cohenor1112/Autonomous-vehicle-W-arduino/פרויקט תחרותי-ספר פרויקט -אור יוני ועידו.pdf

המכללה האק דמית להנדסה אורט בראודה המחלקה להנדסת חשמל ואלקטרוניקה

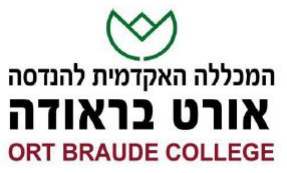
[picture p1: figure]

1

# המחלקה להנדסת חשמל ואלקטרוניקה

# עגלה אוטונומית תחרותית

מוגש ע"י: עידו עזרא ת.ז: 209453935

אור כהן ת.ז: 318300373

יונתן מסטר ת.ז: 311557649

בהנחיית: ד"ר פנחס זורע

2

תקציר:

בפרוייקט זה נעסוק בתכנון ויישום של עגלה אוטונומית תחרותית ,אשר תדע לקלוט אותות אינפרא-אדומים שמשודרים מקצהו השני של החדר. העגלה תבצע מספר בדיקות עד שתמצא את כיוון האות המשודר, ותגיע למשדר תוך כדי הימנעות ממכשולים פיזיים שלבסוף תעצור לידו.

מטרת הפרויקט היא להתחרות בעגלות אוטונומיות אחרות, תוך כדי התגברות על אתגרים שונים המגיעים ממספר גורמים והגעה ליעד בזמן הקצר ביותר בדיוק הרב ביותר.

את האותות הIR יישלח מכלול השידור אשר ימוקם בקצה החדר .אותות הIR מאופננים בתדר 38 KHZ.

את הקליטה והפיענוח מבצע מכלול הקליטה של המערכת. מכלול זה מורכב מ 3- מקלטי IR .מכלול הקליטה מבצע דגימה של המקלטים לאורך כל זמן העבודה של המערכת , ומשדר את המידע הנקלט והרלוונטי למכלול הבקרה ועיבוד נתונים-אותו מכלול שיקבע איך העגלה תתקדם במסלול.

בנוסף לשני המכלולים הנ"ל קיימים עוד שני מכלולים חשובים לא פחות. מכלול ההנעה- מורכב מארבעה מנועי DC אשר מקבלים מתח ממקור חיצוני ,ותוך כדי שימוש בממסרי זרם והגברת הזרם הרצוי, מספקים את הכח הנדרש להזזת המנועים לכיוון הרצוי,על פי הנקבע במכלול העיבוד והקליטה.

מכלול עצירה וזיהוי מכשולים- על מנת למנוע התנגשויות בעצמים והתחמקות ממכשולים בחדר תוכנן מכלול זה. מכלול מורכב מ4 חיישנים אולטרה-סונים המבצעים מדידות באופן רציף לאורך התקדמות העגלה ,ונותנים חיווי למכלול הבקרה האם העגלה נמצאת במרחק אפשרי להתקדמות, ואם ישנו מכלול בדרך, תתריע בהתאם וכך העגלה תפעל לעקיפת המכשול .

על כל המכלולים הנ"ל מפקח מכלול בקרה ועיבוד נתונים. תפקידו של המכלול הוא לקבל את הנתונים מכל החיישנים השונים תוך כדי עיבוד יעיל וביצוע פעולות בכדי לעמוד בדרישות הפרויקט ולהשלים את מטרת הפרויקט.

תכנון הפרויקט כולל תכנון של סט בדיקות שונות עבור המכלולים השונים-שידור,קליטה,בלימה והנעה. הבדיקות השונות כללו סט בדיקות פיזי ותוכנתי במעבדה-לכל מכלול בנפרד. לאחר תכנון וביצוע כל מכלול בנפרד,ותוך כדי שיפור וייעול תמידי של כל אחד מהמכלולים בוצעה איטגרציה בין שאר המכלולים.

3

תוכן עניינים:

.1 מבוא | 5 |
.2 תיאור המערכת | 5...
.2.1 פעולת המערכת/דרישות המערכת5 |
.2.2 מפרט פונקציונלי6 |
.2.3 מפרט טכני6-7 |
2.4 תרשים מלבנים 7 |
.2.5 פירוט מכלולי המערכת8 |
.2.5.1 תכן מכלול עצירה וזיהוי מכשולים8 |
.2.5.2 תכן מכלול הנעה9-10 |
.2.5.3 תכן מכלול בקרה ועיבוד נתונים11-12 |
.2.5.4 תכן מכלול הקליטה13-14 |
.2.5.5 תכן מכלול השידור15-17 |
.3 מטלות הנדסיות18 |
3.1 תיאור המטלות18 |
3.2 אתגרים הנדסיים18 |
.4 סיכום 19 |
4.1 עמידה בדרישות 19 |
4.2 סימוכין 20 |

4

רשימת טבלאות:

טבלה :1 פירוט מכלולי המערכת 6-7 |
טבלה :2 טבלת אמת של מנועי המערכת10 |
טבלה :3 עמידה בדרישות הפרויקט19 |

רשימת איורים:

איור :1 תרשים מלבנים 7 |
איור :2 אופן פעולת חיישן האולטרא סוני 8 |
10 | shield for Arduino Mega :3 איור
איור :4 תרשים זרימת המערכת 11 |
איור :5 תרשים זרימת המערכת במצב זיהוי IR12 |
איור :6 מכלול קליטה- טווח רחוק 13 |
איור :7 מכלול קליטה- טווח קרוב 13 |
איור :8 מכלול שידור אות IR-לטווח רחוק15 |
איור :9 מכלול שידור אות IR - טווח קרוב 16 |
איור :10 פיזור זוויתי של קרן האינפרא-אדום17 |

5

.1מבוא:

עגלה אוטונומית תחרותית היא עגלה אשר תזהה מקור אור אינפרא-אדום, תתביית עליו ותגיע אליו במהירות רבה.
מטרת הפרויקט היא תחרות בין קבוצות שונות .עגלה אוטונומית תחרותית מאפשרת משחק תחרותי מסוג כזה. העגלות הנוספות יהיו מאותו "בסיס" אך יפעלו באופן שונה. מטרת המשחק הינה להגיע מנקודת ההתחלה ועד לנקודת הסיום. המנצח ייקבע על פי 3 פרמטרים:
- מהירות ההגעה לעבר היעד.
- דיוק ההגעה לעבר היעד.
- יכולת התגברות על מכשולים

העגלה תדע להגיע לעבר היעד שלה על ידי זיהוי של מקור אינפרא-אדום המשדר באופן קבוע מצידו השני של החדר ולהגיע אליו. על העגלה ישלוט בקר אשר יידע להפעיל את המנועים עד להגעה ליעד, תוך הימנעות ממכשולים קיימים ע"י חיישנים אולטרה סונים.

.2 תיאור המערכת:

### 2.1 פעולת המערכת/דרישת המערכת:

המערכת תדע לזהות מקור אור אינפרא-אדום בודד אשר נמצא בחדר. המערכת תדע להתביית על המקור לכוון את העגלה ולהגיע למקור האור.

המערכת מבוססת על בקר מסוג Mega Arduino , מקלטי אינפרא-אדום ומשדרי אינפרא-אדום אשר ישמשו למציאת מקור האור וגם לעצירת העגלה לאחר ההגעה אל המטרה. הבקר יקבל מידע דיגיטלי ישירות מהחיישני אינפרא-אדום וידע לעבד אותו על מנת לכוון את העגלה למטרה שלה.

בנוסף המערכת כוללת ארבעה מנועי DC אשר אחראיים על צידוד ימינה או שמאלה וקידום העגלה לעבר המטרה ופלטפורמה עם גלגלים אשר תוכל לשנע את כל הרכיבים.

המערכת תדע לספק קרן אור אינפרא-אדומה מקצה אחד של החדר לקצה השני על ידי תיאום תדרים והגברת האות.

בנוסף, המערכת כוללת חיישנים אולטרא-סוניים שתפקידים מניעת התנגשות העגלה בעצמים ומכשולים בדרכה ליעד.

- המערכת תהיה אוטונומית לחלוטין.
- המערכת תהיה זמינה לפעולה בזמן של עד 15 שניות.
- המערכת תזהה מטרות IR לטווח של עד 5 מטרים.
- המערכת תסחוב משקל של עד 0.3 ק"ג לעבר המטרה.
- המערכת תדע לעבוד בחדרים מישוריים ללא מהמורות מדרגות או הפרשי גבהים בקרקע.

6

### 2.2 מפרט פונקציונלי:

- יכולת סריקת חדר ומציאת מקור אור אינפרא-אדום.
- יכולת התבייתות על מקור האור ונסיעה מדוייקת אליו.
- יכולת תיקון עצמי של כיוון הנסיעה.
- יכולת נשיאת משקל לעבר המטרה.
- יכולת זיהוי מכשולים והימנעות מהם

### 2.3 מפרט טכני:

| | מכלולי המערכת תפקיד פרמטרים
משדרי 333 IR עם דוחף זרם 38 KHz : עבודה תדר-Arduino Uno | | .1 מכלול שידור ייצור קרן אור אינפרא-אדומה.
IR TSOP 34838f מקלטי 38 KHz: עבודה תדר-Arduino Nano | יצירת תחום קליטת אור של 90⁰ בקידמת העגלה וקליטת אור אינפרא-אדום המגיע ממכלול השידור. תרגום רמת האור הנקלטת לפלט דיגיטלי המוזן לתוך מכלול הבקרה והעיבוד. | מכלול קליטה 2.
Arduino mega 2560 | עיבוד המידע המגיע מהחיישנים והפעלת מכלול ההנעה בהתאם לאלגוריתם. | מכלול בקרה ועיבוד 2. נתונים
TT130-Gear DC motor מנוע-X4 )עם דוחף זרם לכל מנוע( | הנעת העגלה לעבר המטרה במהירות ובדיוק המקסימלי. | .4 מכלול הנעה
חיישן מרחק אולטראסוני 4X 2 מרחק מקסימלי: m4 -מרחק מינימלי:cm - | הפסקת הפעולה של מכלול ההנעה כאשר העגלה הגיע למטרה שלה. | .5 מכלול עצירה וזיהוי מכשולים

טבלה 1 : פירוט מכלולי המערכת

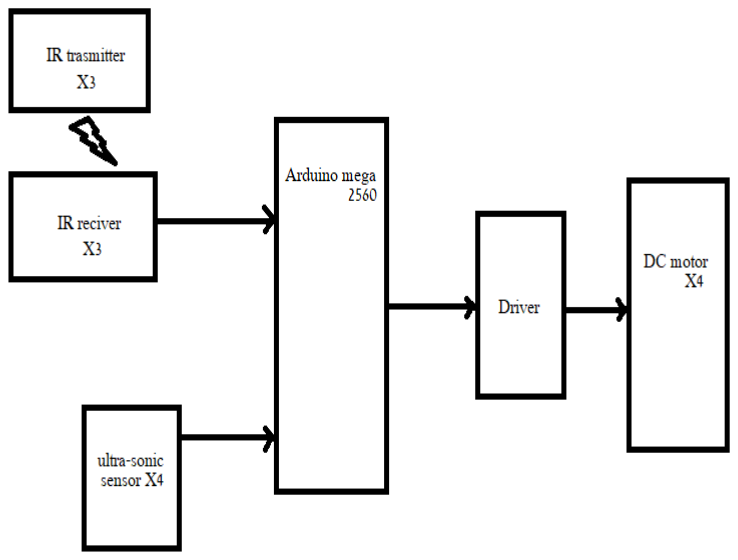
[picture p2: figure]

7

### 2.4 תרשים מלבנים

איור :1תרשים מלבנים

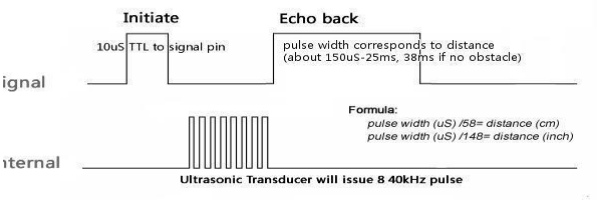
[picture p3: figure]

8

### 2.5 פירוט מכלולי המערכת

### 2.5.1 תכן מכלול עצירה וזיהוי מכשולים

מטרת מכלול זה היא לספק למערכת יכולת לזהות עצמים במרחקים שונים, וע"י עיבוד הנתונים מאפשר התחמקות ממכשולים שונים שהעגלה תפגוש ,בדרך אל המשדר IR . ועצירה ברגע הגעתו אל המשדר.

רכיבי המכלול:

]1] Ultrasonic Ranging Module HC – SR סוני- | אולטרא | חיישן | •

אופן פעולת החיישן האולטראסוני:

- החיישן בנוי ממשדר ומקלט פולסים חשמליים.
- המשדר , משדר אות אולטרא-סאונד בתדר של 40 ]KHz ]לחלל החדר.
- האות פוגע בעצם כלשהו שנמצא מול החיישן ומחזיר את האות למקלט.
- החיישן ייכנס לפעולה תחת התנאים הבאים:

תחילה החיישן יקבל פולס ברוחב של [µ [,10 זה אות ה – Trigger.

לאחר מכן החיישן ישדר 8 פולסים אולטראסוניים רצופים ואז ייכנס למצב קליטה, Echo.

איור :2 אופן פעולת החיישן האולטרא סוני

בזמן ה – Echo החיישן ימתין לחזרת האות ששידר ויתזמן את חזרתו.

מכלול זה עובד באופן רציף ומודד את המרחק לעצם הקרוב ביותר שיכול להפריע לפעולת העגלה. המרחק המינימלי הנדרש לתפעול המעגל ולהימנע מפגיעה בעצם שכזה נקבע על ידי חישוב מימדי העגלה.

9

### 2.5.2 תכן מכלול הנעה:

- מטרתו של מכלול זה היה לנייד את העגלה מנקודה אחת לנקודה מסויימת , במהירויות שונות .
- למכלול זה נבחרו 4 מנועי DC מסוג TT ,130 וshield אשר הורכב על גבי בקר ה arduino mega. כאשר ה-shield מתנהג כדוחף זרם למנועים וכך מספק זרם מספיק להפעלת המנועים בטווח מהירויות על פי דרישה .
- ארבעת המנועים מחוברים ע"י קווי Vcc ו GND למתחי האספקה והאדמה של ה-shield.
- מכיוון שמנוע הוא צרכן זרם גדול ובפרויקט זה ישנם 4 מנועים שצריכים לעבוד לפרקי זמן ארוכים אין ביכולתו של בקר ה-mega arduino לספק את הזרם הנדרש לצורך הפעלתם,לשם כך הורכב ה-shield.
- ה-shield מחובר ע"י פינים לבקר ה-mega arduino ,וע"י כך אנו מבקרים את הפעלת המנועים ע"פ הלוגיקה שנתונה בטבלה הבאה.

רכיבי המכלול:

TT130-Gear DC motor | מנועי | 4•

Compatible shield for Arduino Mega •

Direction Of Rotation | m1,m3 | m2,m4
Backward | LOW | LOW
Right | LOW | HIGH
Left | HIGH | LOW
Forward | HIGH | HIGH

טבלה 2 : טבלת אמת של מנועי המערכת]6[

סיווג המנועים:

m2- front left motor* | m1- front right motor.*
. m4- rear left motor.* | m3- rear right motor*

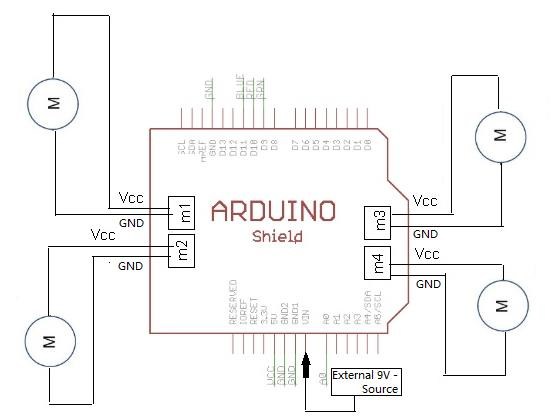
[picture p4: figure]

10

תנועת העגלה תלויה במצבים שונים בהתאם לקריאות המגיעות מהחיישנים במערכת. כל תנועה מחולקת לפונקציה ספציפית שיודעת לתת את המתחים הרלוונטיים עבור כל מנוע בנפרד ולבצע את עבודתה.

shield for Arduino Mega :3 איור

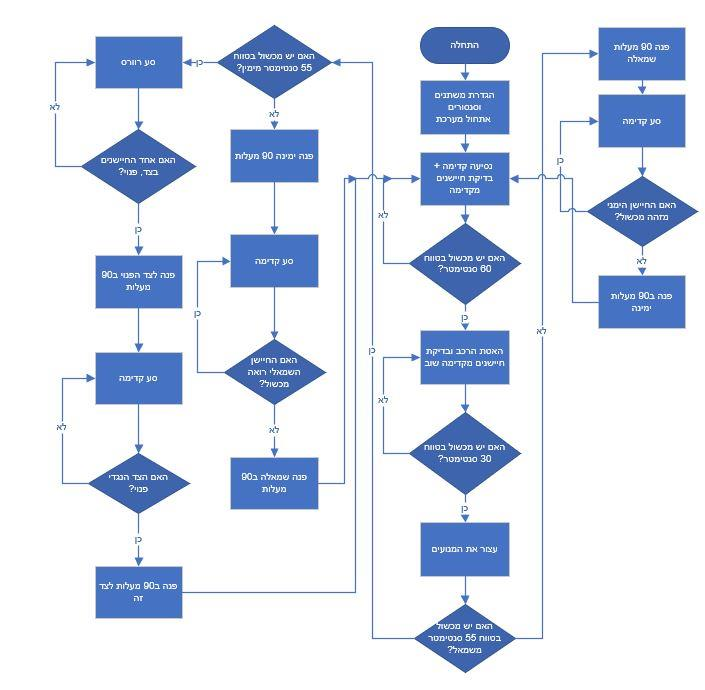
[picture p5: figure]

11

### 2.5.3 תכן מכלול בקרה ועיבוד נתונים:

מטרת המכלול: איסוף כלל המידע והנתונים השונים המגיעים מכל המכלולים במערכת ולקבל החלטות לגבי שלבי הפעולה הבאים של העגלה כאשר לבסוף היא מבצעת את מטרתה.

איור :4 תרשים זרימת המערכת

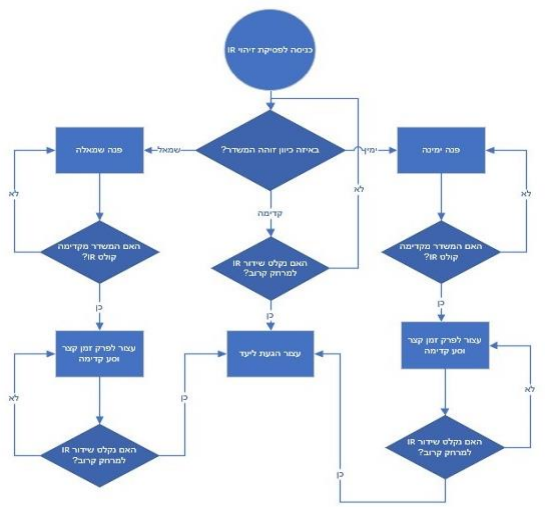
[picture p6: figure]

12

בסוף לכך קיים תרשים זרימה ממשיך למצב שבו בוצעה פסיקה כלומר זוהה אות IR:

איור :5 תרשים זרימת המערכת במצב זיהוי IR

החומרה הנמצאת בשימוש במכלול - Mega Arduino 2560[ 3 ]:

- בפרוייקט זה לא קיימת דרישה ליכולת עיבוד נתונים ברמה גבוהה במיוחד, ולכן השימוש במיקרו בקר מהסוג הזה עונה על דרישות הפרויקט.
- גודל ומשקל הבקר קטנים יחסית ומתאימים לאפליקציה שלנו.

קליטת אות אינפרא-אדום:

בקר ארדואינו ננו מנהל את כל מערך הקליטה )3 מקלטים( , תחנת השידור משדרת בתדר מסויים המקלטים קולטים ומעברים את המידע לננו , הוא מחשב את התדר שנקלט ואם זה התדר שהגדרנו מראש הננו יבצע פסיקה למגה" ויגיד לו" איזה מקלט קלט , כלומר איזה כיוון.

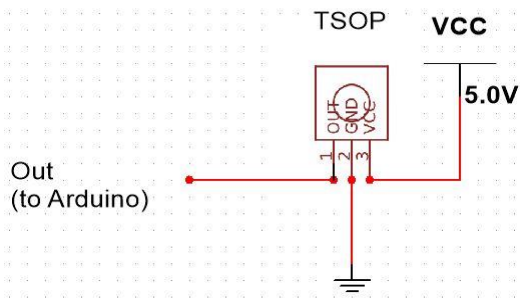
[picture p7: figure]
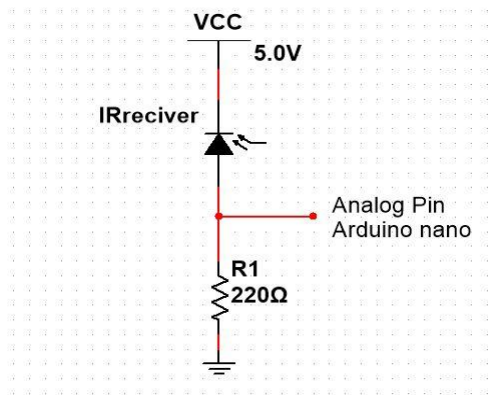
[picture p8: figure]

13

### 2.5.4 תכן מכלול הקליטה:

החומרה שבשימוש במכלול:

34838. IR – TSOP | מקלטי | •
- בקר מסוג Nano Arduino.
- בקר מסוג Mega Arduino.

שרטוט מערך הקליטה:

איור :6 מכלול קליטה-טווח רחוק

בעצם המקלט קולט ומעביר דרך רגל 1 את המידע לארדואינו ננו שנותן פסיקה לארדואינו מגה.

מלבד הקליטה הרגילה, למערכת ישנה אופציה לזיהוי תחנת השידור ע"י מקלטים IR לטווח קרוב:

איור :7 מכלול קליטה-טווח קרוב

14

הבקר שאחרי על הקליטה בודק לאחר שזוהתה תחנה את המקלטים לטווח קרוב, אם ערכם גדול עולה על ערך מסוים המקלטים מודיעים לרכב שזוהתה תחנה.

יתרונות המכלול:

- מאפשר קליטה של מידע מאופנן בתדר עבודה של 38 KHz
- מקלט זול ואמין אשר עובד בטווח התדרים הרצוי [KHz [.38-40
- טווח קליטת המשדר בתנאי מעבדה-עד 5 מטר
- טווח קליטת קרני אינפרא אדום – 90 מעלות.
- זיהוי תחנת שידור בפריסה של 180 מעלות.
- עגינה בתחנת שידור
- על מנת להימנע מהפרעות בסביבה נבנה קייס למקלט להפחתת רעשים.

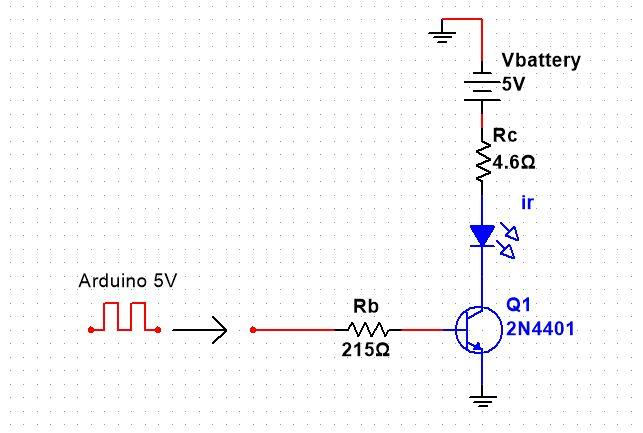
[picture p9: figure]

15

### 2.5.5 תכן מכלול שידור:

- מטרת מכלול זה היא לספק למערכת אות IR בתדר רצוי.
- המכלול תוכנן לעבודה במרחקים רחוקים עד 7 מטרים.
- המכלול נבנה בפריסת משדרים בטווח 180 מעלות.

רכיבי מכלול השידור:

- Arduino Uno
- IR-333A Led
- 4.6 [KΩ] ,215 [Ω] - Resistors
- 2N4401 NPN Transistor
- 5V external battery source

אפנון האות מתבצע על ידי בקר הארדואינו של מכלול השידור. הבקר שולח סדרה של פולסים בתדר של 38 ]KHz ].כמו כן המידע מאופנן בתדר של [Hz [1000

איור :8 מכלול שידור אות IR

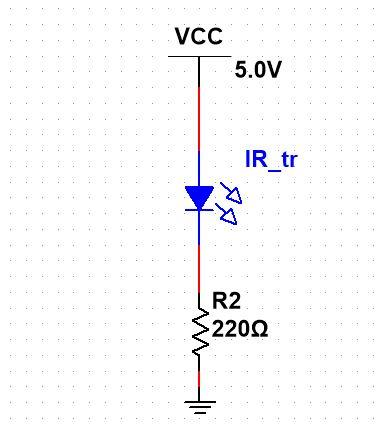
[picture p10: figure]

16

בנוסף לשידור לטווח הרחוק , ישנו מערך משדרים לטווח קרוב כך ע"י שילוב עם קליטה לטווח קרוב נדע כי אנו קרובים לתחנת השידור:

איור 9 : מכלול שידור אות IR לטווח קרוב

לגבי טווח ארוך:

- על מנת לבצע את המשימה הזאת הוחלט כי ה – Led IR לטווח רחוק יחובר למקור חיצוני שיוכל להתגבר על מגבלת הזרם הנמוך בארדואינו ויספק את הזרם הגבוה הנדרש לשידור (500mA)
- רגל D8 של הבקר מוציאה אות חשמלי בתדר 38 ]KHz ]עם זרם נמוך שמסוגל להפעיל את הטרנזיסטור.
- לפי דפי נתונים של הטרנזיסטור על מנת להגיע לזרם בקולטקור של 500 מילי צריך זרם בסיס של 20 מיליאמפר ו מתח קולקטור אמיטר במצב רוויה 0.5 וולט. )בהנחה שמפל המתח על ה LED IR הוא 2.2 וולט(
5−0.5−2.2 | ולכן: = ֹR
500m

= 4.6Ω

בחרנו נגד הכי קרוב לערך הרצוי שקיים Ω4.7 בנסוף זה נגד שעומד בהספקים של 2 וואט

על מנת להכניס את הטרנזיסטור לרוויה עלינו לגרום לזרם בסיס שיהיה גדול יותר מזרם הקולקטור חלקי הקבוע β.

לכן גילנו כי ערך זרם הבסיס צריך להיות 20 מיליאמפר ולפי החישוב הבא מצאנו את נגד הבסיס:

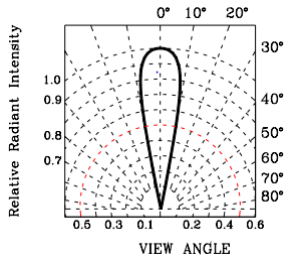
[picture p11: figure]

17

RB =

5 − VBE
20m

=

5 − 0.7
20m

= 215Ω

*בחרנו ערך מעשי של Ω.220

- גורם מכריע נוסף בתכנון מכלול זה היה צורת המשדר.

כפי שניתן ללמוד מדף הנתונים של ה Led IR שידור אות האינפרא-אדום מתבצע תוך פיזור זוויתי במרחב, כמתואר באיור. פיזור באופן כזה בתוך חדר סגור עלול לגרום לטעויות בזיהוי על ידי מכלול הקליטה ולגרום לזהות אותם כמטרות שווא.

איור :10 פיזור זוויתי של קרן האינפרא-אדום

על מנת להתגבר על בעיית פיזור האות, נדרש לבצע מיקוד של האות המשודר.

הפתרון שהובא הוא הוספת כיסוי העשוי פלסטיק, למשדר האינפרא-אדום.

יתרונות המכלול:

- שידור למרחקים מאוד גבוהים )עד 7 מטרים(
- שידור בצורה מרחבית לפריסה מקסימלית )180 מעלות(
- שידור בטווח קרוב ורחוק בנפרד למען עזרה למכונית להתמצאות באקיזה מרחק היא מהמשדר.

18

.3 מטלות הנדסיות:

### 3.1 תיאור המטלות:

- כתיבת הצעת פרויקט.
- הכרות ועבודה מעמיקה עם תוכנת IDE Arduino.
- הכרת המיקרו-בקר לעומק.
- בחירת רכיבי חומרה ופלטפורמות מתאימות לביצוע המשימה.
- הכרת העבודה עם מנועי DC ועם דוחפי הזרם המפעילים אותם.
•
- הכרת השימוש בחיישני אינפרא-אדום, מקלטים ומשדרים.
- תיכנון רכיב שידור אינפרא-אדום למרחק הנדרש.
- תיכנון מכלול הבלימה בצורה שתענה על דרישות הפרויקט.
- כתיבת אלגוריתם לזיהוי מקור אור אינפרא-אדום והתבייתות עליו.
- כתיבת אלגוריתם למכלול בקרה ועיבוד נתונים.
- אינטגרציה של המערכת כולה.
- בדיקת המערכת תחת תנאי עבודה שונים, איתור תקלות ובעיות שונות ופיתוח סט בדיקות מתאים ותיקונן.
- כתיבת ספר פרויקט.
- הכנת מצגת לפרויקט.

### 3.2 אתגרים הנדסיים:

- כתיבת אלגוריתם לזיהוי מדויק ורציף של שידור אינפרא-אדום.
- אינטגרציה בין כל חלקי המערכת.
- התמודדת עם החזרות אור אינפרא-אדום מחלקים שונים במרחב.
- זיהוי ומניעה של מטרת שווא.
- שידור אור אינפרא-אדום למרחק הנדרש בפרויקט.
- תכן מכלול זיהוי המכשולים וכתיבת אלוגריתם מתאים
- התאמת רכיבים חומרתיים למכלולי המערכת.
- חיווט וחיבור המערכת.
- איתור תקלות ובעיות בתנאים שונים
- הרצה ובדיקת המערכת ושיפורה

19

.4 סיכום

### 4.1 עמידה בדרישות

| מטלה סטטוס ביצוע
| | 1 סריקת חדר ומציאת מקור קרני אינפרא-אדום. בוצע
| | 2 התבייתות על מקור השידור, ונסיעה מדויקת לכיוונו. בוצע
בוצע | השידור. | 3 יכולת תיקון עצמי של כיוון הנסיעה, לאחר איבוד מקור
בוצע | בתנועתה. | 4 יכולת נשיאת משקל לעבר המטרה, ללא פגיעה
| | 5 זיהוי מטרות דמה והימנעות מזיהוי שלהן כקו הסיום. בוצע
| | 6 הימנעות התנגשות בעצמים, ומטרות דמה . בוצע

טבלה -3 עמידה בדרישות הפרוייקט

20

### 4.2 סימוכין:

- [1] https://cdn.sparkfun.com/datasheets/Sensors/Proximity/HCSR04.pdf
- [2] http://forum.arduino.cc/index.php?action=dlattach;topic=293864.0;attach=110567
- [3] https://store.arduino.cc/usa/arduino-mega-2560-rev3
- [4] https://www.vishay.com/docs/82489/tsop322.pdf
- [5] https://store.arduino.cc/usa/arduino-uno-rev3
- [6] https://cdn-shop.adafruit.com/datasheets/IR333_A_datasheet.pdf
- [7] http://howtomechatronics.com/tutorials/arduino/ultrasonic-sensor-hc-sr04/
- [8] https://blog.oureducation.in/modulation-and-demodulation-based-interview-questions/
- [9] http://www.farnell.com/datasheets/661741.pdf
- [10] https://www.arduino.cc/en/uploads/Main/ArduinoNanoManual23.pdf
