cohenor1112/Autonomous-vehicle-W-arduino/codes/version6_with_ir_with_intterupts_with_stop_final/version6_with_ir_with_intterupts_with_stop_final.txt

קטע קוד זה תפקידו לרוץ על הבקר המרכזי (ארדואינו מגה).

תפקידו לנהל את כלל הפעולות , הוא מקבל פסיקות מהארדואינו אונו ש"מנדנד" לו מתי שהוא מרגיש קליטות מתחנת השידור.
עד אז תפקידו בגדול להימנע ממכשולים בצורה חכמה כך שתמיד ינסה להמשיך "קדימה".
ברגע שמרגיש פסיקה הוא כמובן נוסע ישירות לכיוון השידור.
